marangisto/Resonator/Spice/CodecOutput.asc

C1: cap; 470p
C2: cap; 470p
C3: cap; 1500p
R1: res; 820
R2: res; 10k
R3: res; 820
R4: res; 10k
R5: res; 15k
R6: res; 33k
R7: res; 33k
R28: res; 1k
R29: res; 15k
U1: opamp2; TL071
U4: opamp2; TL071
V1: voltage; 12
V2: voltage; SINE(0 5 1k); AC 1
V3: voltage; -12
V4: voltage; 2.5
V5: voltage; 5
Vcv: voltage; PWL(0 2.5 1m 2.5 2m 4.5 4m 0.5 5m 2.5)
Named nets: 0, VCC, VSS, Vin2, Vin, Output, VOut+, VCom, V5V, VOut-
.include TL071.mod
.tran 0 6mm 0 500n
