marangisto/Resonator/Spice/CodecInput.asc

C1: cap; 10µ
C2: cap; 120p
D1: schottky; 1N5819
D2: schottky; 1N5819
R3: res; 100k
R28: res; 1k
R29: res; 30k
U4: opamp2; TL071
V1: voltage; 12
V2: voltage; SINE(0 5 1k); AC 1
V3: voltage; -12
V4: voltage; 2.5
V5: voltage; 5
Vcv: voltage; PWL(0 0 1m 0 2m -5 3m 5 4m 0 5m 0 6m -12 8m 12 9m 0 10m 0)
Named nets: 0, VCC, VSS, Vin2, Vin, Out, VCom, V5V
.include TL071.mod
.tran 0 10mm 0 500n
