marangisto/Resonator/Resonator.kicad_pcb

## KiCad design Resonator.kicad_pcb (2022-01-10)

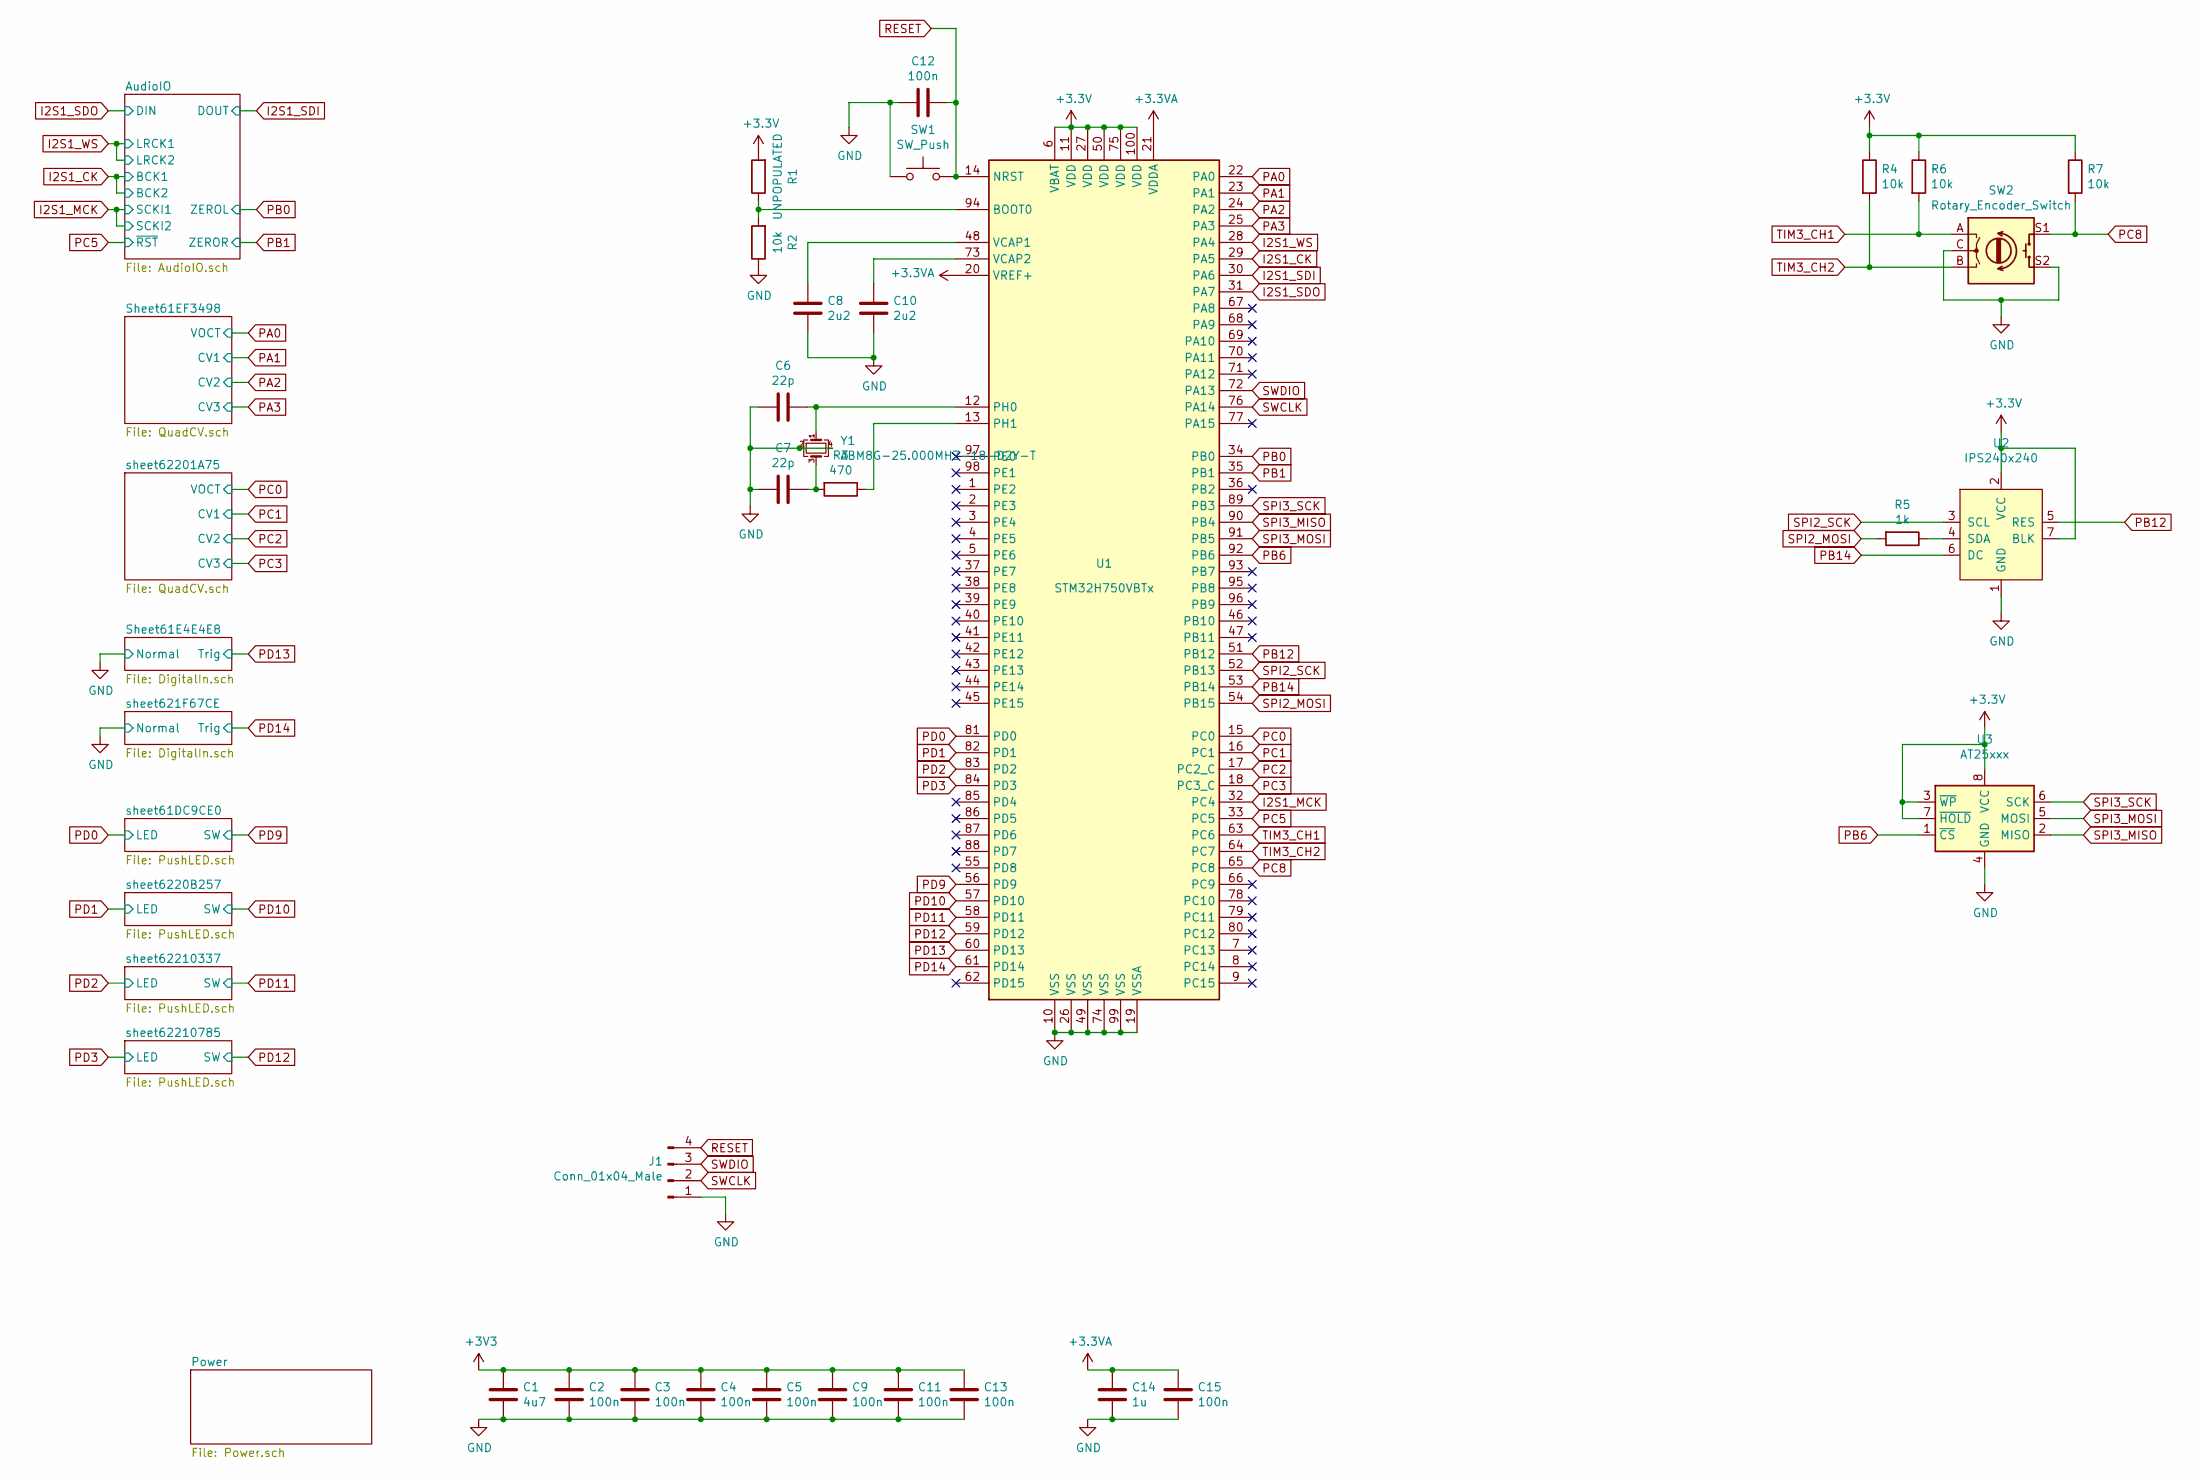
[picture p1: schematic Resonator.sch]

Parts:
C1: 4u7; C_0805_2012Metric
C2, C3, C4, C5, C9, C11, C12, C13, C15: 100n; C_0402_1005Metric
C6, C7: 22p; C_0402_1005Metric
C8, C10: 2u2; C_0805_2012Metric
C14: 1u; C_0805_2012Metric
J1: Conn_01x04_Male; PinHeader_1x04_P2.54mm_Vertical
R1: UNPOPULATED; R_0603_1608Metric
R2, R4, R6, R7: 10k; R_0603_1608Metric
R3: 470; R_0603_1608Metric
R5: 1k; R_0603_1608Metric
SW1: SW_Push; SW_PUSH_6mm
SW2: Rotary_Encoder_Switch; RotaryEncoder_Alps_EC11E-Switch_Vertical_H20mm
U1: STM32H750VBTx; LQFP-100_14x14mm_P0.5mm
U2: IPS240x240
U3: AT25xxx; TSSOP-8_4.4x3mm_P0.65mm
Y1: ABM8G-25.000MHZ-18-D2Y-T; Crystal_SMD_Abracon_ABM8G-4Pin_3.2x2.5mm

Connections:
+3.3VA: C14.1, C15.1, U1.20 (VREF+), U1.21 (VDDA); also elsewhere on the board
GND: C1.2, C2.2, C3.2, C4.2, C5.2, C6.2, C7.2, C8.2, C9.2, C10.2, C11.2, C12.2, C13.2, C14.2, C15.2, J1.1, R2.1, SW1.1, SW2.C, SW2.S2, U1.10 (VSS), U1.19 (VSSA), U1.26 (VSS), U1.49 (VSS), U1.74 (VSS), U1.99 (VSS), U2.1 (GND), U3.4 (GND), Y1.2, Y1.4; also elsewhere on the board
I2S1_CK: U1.29 (PA5); also elsewhere on the board
I2S1_MCK: U1.32 (PC4); also elsewhere on the board
I2S1_SDI: U1.30 (PA6); also elsewhere on the board
I2S1_SDO: U1.31 (PA7); also elsewhere on the board
I2S1_WS: U1.28 (PA4); also elsewhere on the board
unnamed: C6.1, U1.12 (PH0), Y1.1
unnamed: C7.1, R3.2, Y1.3
unnamed: C8.1, U1.48 (VCAP1)
unnamed: C10.1, U1.73 (VCAP2)
unnamed: R1.1, R2.2, U1.94 (BOOT0)
unnamed: R3.1, U1.13 (PH1)
unnamed: R5.1, U2.4 (SDA)
PA0: U1.22 (PA0); also elsewhere on the board
PA1: U1.23 (PA1); also elsewhere on the board
PA2: U1.24 (PA2); also elsewhere on the board
PA3: U1.25 (PA3); also elsewhere on the board
PB0: U1.34 (PB0); also elsewhere on the board
PB1: U1.35 (PB1); also elsewhere on the board
PB6: U1.92 (PB6), U3.1 (~CS)
PB12: U1.51 (PB12), U2.5 (RES)
PB14: U1.53 (PB14), U2.6 (DC)
PC0: U1.15 (PC0); also elsewhere on the board
PC1: U1.16 (PC1); also elsewhere on the board
PC2: U1.17 (PC2_C); also elsewhere on the board
PC3: U1.18 (PC3_C); also elsewhere on the board
PC5: U1.33 (PC5); also elsewhere on the board
PC8: R7.2, SW2.S1, U1.65 (PC8)
PD0: U1.81 (PD0); also elsewhere on the board
PD1: U1.82 (PD1); also elsewhere on the board
PD2: U1.83 (PD2); also elsewhere on the board
PD3: U1.84 (PD3); also elsewhere on the board
PD9: U1.56 (PD9); also elsewhere on the board
PD10: U1.57 (PD10); also elsewhere on the board
PD11: U1.58 (PD11); also elsewhere on the board
PD12: U1.59 (PD12); also elsewhere on the board
PD13: U1.60 (PD13); also elsewhere on the board
PD14: U1.61 (PD14); also elsewhere on the board
RESET: C12.1, J1.4, SW1.2, U1.14 (NRST)
SPI2_MOSI: R5.2, U1.54 (PB15)
SPI2_SCK: U1.52 (PB13), U2.3 (SCL)
SPI3_MISO: U1.90 (PB4), U3.2 (MISO)
SPI3_MOSI: U1.91 (PB5), U3.5 (MOSI)
SPI3_SCK: U1.89 (PB3), U3.6 (SCK)
SWCLK: J1.2, U1.76 (PA14)
SWDIO: J1.3, U1.72 (PA13)
TIM3_CH1: R6.2, SW2.A, U1.63 (PC6)
TIM3_CH2: R4.2, SW2.B, U1.64 (PC7)

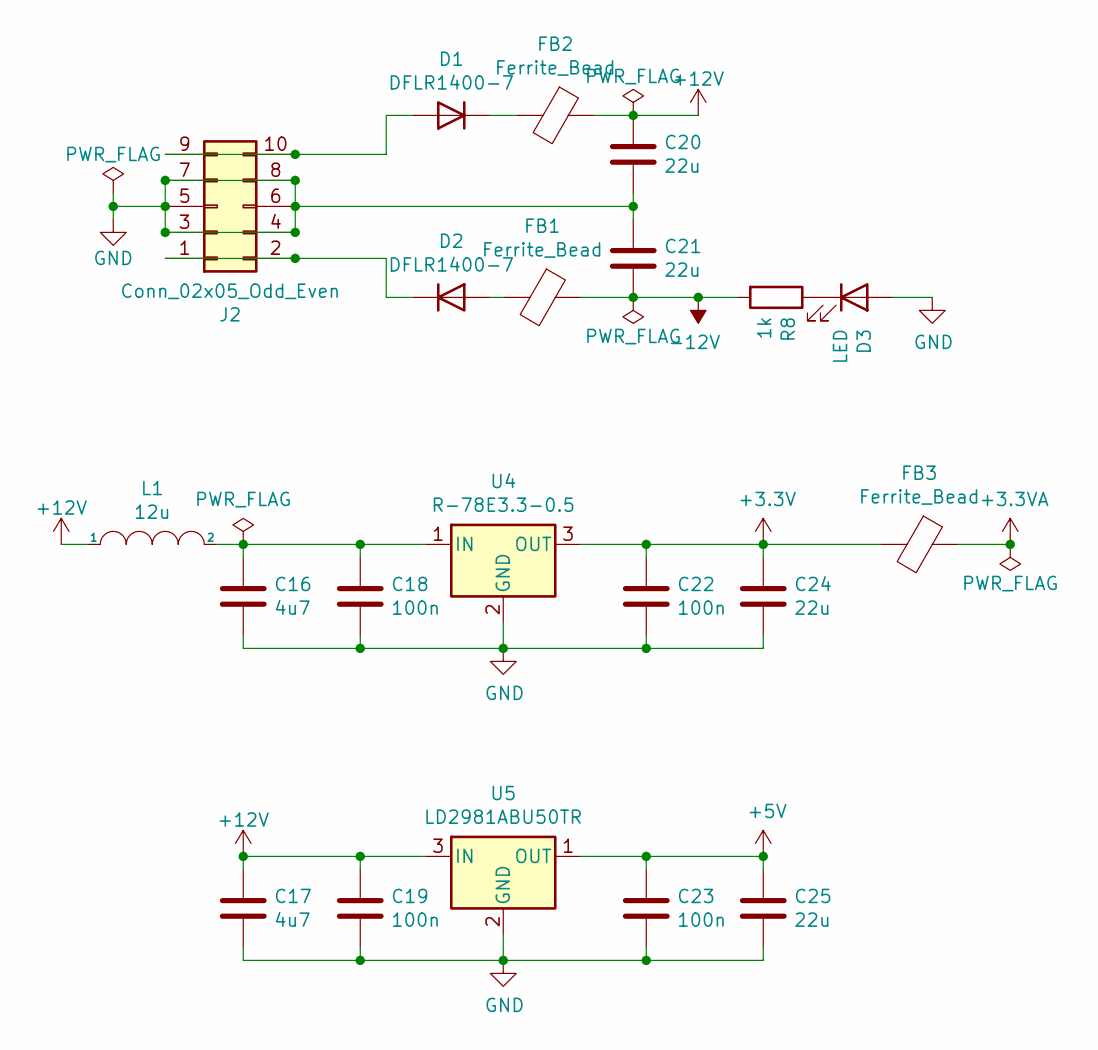
[picture p2: schematic Power.sch]

Parts:
C16, C17: 4u7; C_0805_2012Metric
C18, C19, C22, C23: 100n; C_0402_1005Metric
C20, C21, C24, C25: 22u; C_1206_3216Metric
D1, D2: DFLR1400-7; D_PowerDI-123
D3: LED; LED_0603_1608Metric_Castellated
FB1, FB2, FB3: Ferrite_Bead; L_0603_1608Metric
J2: Conn_02x05_Odd_Even; PinHeader_2x05_P2.54mm_Vertical
L1: 12u; L_Coilcraft_LPS3010
R8: 1k; R_0603_1608Metric
U4: R-78E3.3-0.5; Converter_DCDC_RECOM_R-78E-0.5_THT
U5: LD2981ABU50TR; SOT-89-3

Connections:
+3.3VA: FB3.1; also elsewhere on the board
+5V: C23.1, C25.1, U5.1 (OUT); also elsewhere on the board
+12V: C17.1, C19.1, C20.1, FB2.1, L1.1, U5.3 (IN); also elsewhere on the board
-12V: C21.2, FB1.1, R8.2; also elsewhere on the board
GND: C16.2, C17.2, C18.2, C19.2, C20.2, C21.1, C22.2, C23.2, C24.2, C25.2, D3.2 (A), J2.3, J2.4, J2.5, J2.6, J2.7, J2.8, U4.2 (GND), U5.2 (GND); also elsewhere on the board
unnamed: C16.1, C18.1, L1.2, U4.1 (IN)
unnamed: D1.1 (K), FB2.2
unnamed: D1.2 (A), J2.9, J2.10
unnamed: D2.1 (K), J2.1, J2.2
unnamed: D2.2 (A), FB1.2
unnamed: D3.1 (K), R8.1

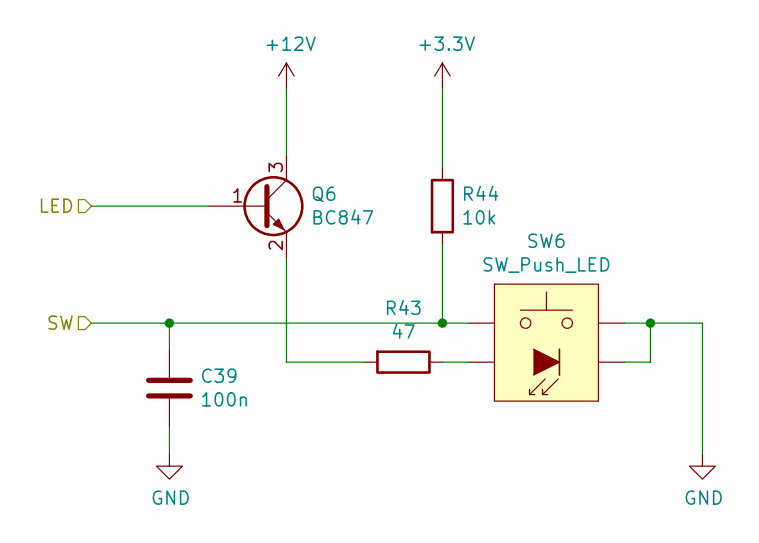
[picture p3: schematic PushLED.sch]

Parts:
C26: 100n; C_0402_1005Metric
Q1: BC847; SOT-23
R9: 47; R_0603_1608Metric
R10: 10k; R_0603_1608Metric
SW3: SW_Push_LED; SW_PUSH_LED_6mm

Connections:
+12V: Q1.3 (C); also elsewhere on the board
GND: C26.2, SW3.2, SW3.4 (K); also elsewhere on the board
unnamed: Q1.2 (E), R9.2
unnamed: R9.1, SW3.3 (A)
PD0: Q1.1 (B); also elsewhere on the board
PD9: C26.1, R10.2, SW3.1; also elsewhere on the board

Parts of its further copies:
C37, C38, C39: 100n; C_0402_1005Metric
Q4, Q5, Q6: BC847; SOT-23
R39, R41, R43: 47; R_0603_1608Metric
R40, R42, R44: 10k; R_0603_1608Metric
SW4, SW5, SW6: SW_Push_LED; SW_PUSH_LED_6mm

Connections of its further copies:
+12V: Q4.3 (C), Q5.3 (C), Q6.3 (C); also elsewhere on the board
GND: C37.2, C38.2, C39.2, SW4.2, SW4.4 (K), SW5.2, SW5.4 (K), SW6.2, SW6.4 (K); also elsewhere on the board
unnamed: Q4.2 (E), R39.2
unnamed: Q5.2 (E), R41.2
unnamed: Q6.2 (E), R43.2
unnamed: R39.1, SW4.3 (A)
unnamed: R41.1, SW5.3 (A)
unnamed: R43.1, SW6.3 (A)
PD1: Q4.1 (B); also elsewhere on the board
PD2: Q5.1 (B); also elsewhere on the board
PD3: Q6.1 (B); also elsewhere on the board
PD10: C37.1, R40.2, SW4.1; also elsewhere on the board
PD11: C38.1, R42.2, SW5.1; also elsewhere on the board
PD12: C39.1, R44.2, SW6.1; also elsewhere on the board

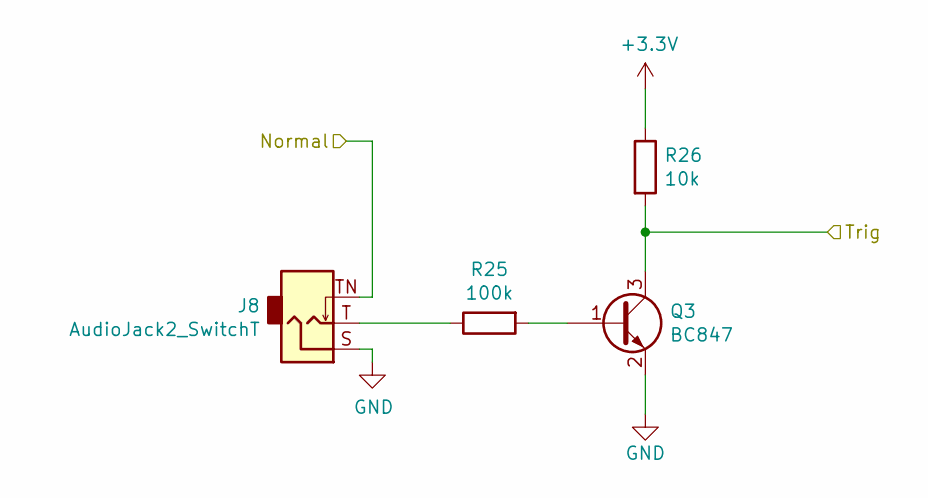
[picture p4: schematic DigitalIn.sch]

Parts:
J3: AudioJack2_SwitchT; PJ398SM
Q2: BC847; SOT-23
R11: 100k; R_0603_1608Metric
R12: 10k; R_0603_1608Metric

Connections:
GND: J3.S, J3.TN, Q2.2 (E); also elsewhere on the board
unnamed: J3.T, R11.1
unnamed: Q2.1 (B), R11.2
PD13: Q2.3 (C), R12.2; also elsewhere on the board

Parts of its further copies:
J8: AudioJack2_SwitchT; PJ398SM
Q3: BC847; SOT-23
R25: 100k; R_0603_1608Metric
R26: 10k; R_0603_1608Metric

Connections of its further copies:
GND: J8.S, J8.TN, Q3.2 (E); also elsewhere on the board
unnamed: J8.T, R25.1
unnamed: Q3.1 (B), R25.2
PD14: Q3.3 (C), R26.2; also elsewhere on the board

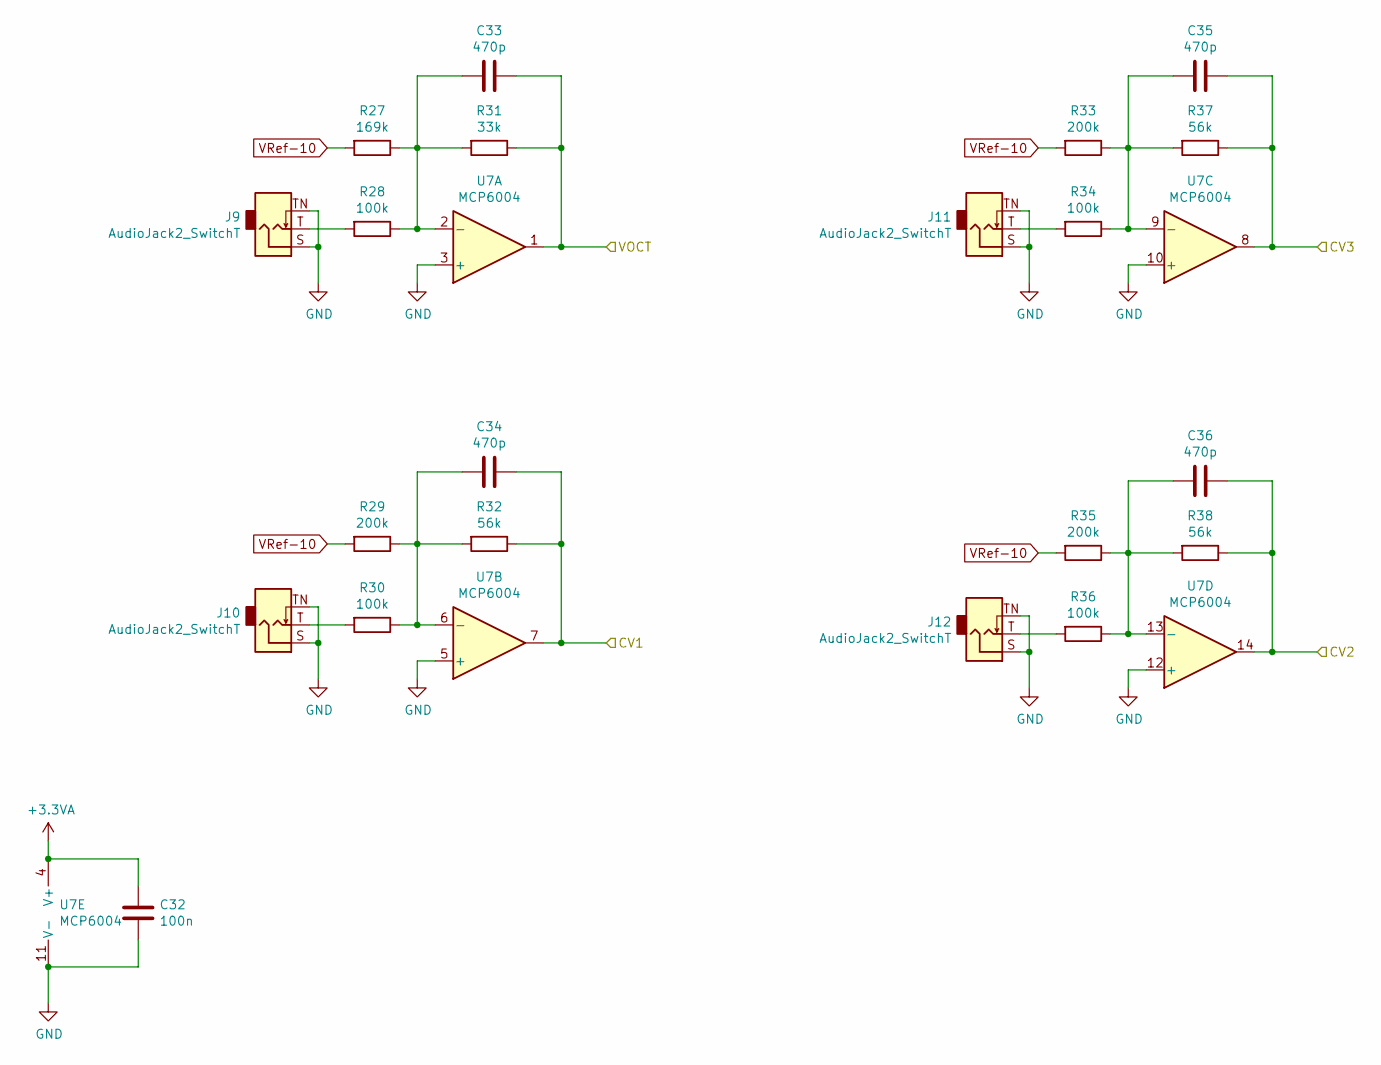
[picture p5: schematic QuadCV.sch]

Parts:
C27: 100n; C_0402_1005Metric
C28, C29, C30, C31: 470p; C_0603_1608Metric
J4, J5, J6, J7: AudioJack2_SwitchT; PJ398SM
R13: 169k; R_0603_1608Metric
R14, R16, R20, R22: 100k; R_0603_1608Metric
R15, R19, R21: 200k; R_0603_1608Metric
R17: 33k; R_0603_1608Metric
R18, R23, R24: 56k; R_0603_1608Metric
U6: MCP6004; TSSOP-14_4.4x5mm_P0.65mm

Connections:
+3.3VA: C27.1, U6.4 (V+); also elsewhere on the board
GND: C27.2, J4.S, J4.TN, J5.S, J5.TN, J6.S, J6.TN, J7.S, J7.TN, U6.3 (+), U6.5 (+), U6.10 (+), U6.11 (V-), U6.12 (+); also elsewhere on the board
unnamed: C28.2, R13.1, R14.1, R17.2, U6.2 (-)
unnamed: C29.2, R15.1, R16.1, R18.2, U6.6 (-)
unnamed: C30.2, R19.1, R20.1, R23.2, U6.9 (-)
unnamed: C31.2, R21.1, R22.1, R24.2, U6.13 (-)
unnamed: J4.T, R14.2
unnamed: J5.T, R16.2
unnamed: J6.T, R20.2
unnamed: J7.T, R22.2
PA0: C28.1, R17.1, U6.1; also elsewhere on the board
PA1: C29.1, R18.1, U6.7; also elsewhere on the board
PA2: C31.1, R24.1, U6.14; also elsewhere on the board
PA3: C30.1, R23.1, U6.8; also elsewhere on the board
VRef-10: R13.2, R15.2, R19.2, R21.2; also elsewhere on the board

Parts of its further copies:
C32: 100n; C_0402_1005Metric
C33, C34, C35, C36: 470p; C_0603_1608Metric
J9, J10, J11, J12: AudioJack2_SwitchT; PJ398SM
R27: 169k; R_0603_1608Metric
R28, R30, R34, R36: 100k; R_0603_1608Metric
R29, R33, R35: 200k; R_0603_1608Metric
R31: 33k; R_0603_1608Metric
R32, R37, R38: 56k; R_0603_1608Metric
U7: MCP6004; TSSOP-14_4.4x5mm_P0.65mm

Connections of its further copies:
+3.3VA: C32.1, U7.4 (V+); also elsewhere on the board
GND: C32.2, J9.S, J9.TN, J10.S, J10.TN, J11.S, J11.TN, J12.S, J12.TN, U7.3 (+), U7.5 (+), U7.10 (+), U7.11 (V-), U7.12 (+); also elsewhere on the board
unnamed: C33.2, R27.1, R28.1, R31.2, U7.2 (-)
unnamed: C34.2, R29.1, R30.1, R32.2, U7.6 (-)
unnamed: C35.2, R33.1, R34.1, R37.2, U7.9 (-)
unnamed: C36.2, R35.1, R36.1, R38.2, U7.13 (-)
unnamed: J9.T, R28.2
unnamed: J10.T, R30.2
unnamed: J11.T, R34.2
unnamed: J12.T, R36.2
PC0: C33.1, R31.1, U7.1; also elsewhere on the board
PC1: C34.1, R32.1, U7.7; also elsewhere on the board
PC2: C36.1, R38.1, U7.14; also elsewhere on the board
PC3: C35.1, R37.1, U7.8; also elsewhere on the board
VRef-10: R27.2, R29.2, R33.2, R35.2; also elsewhere on the board

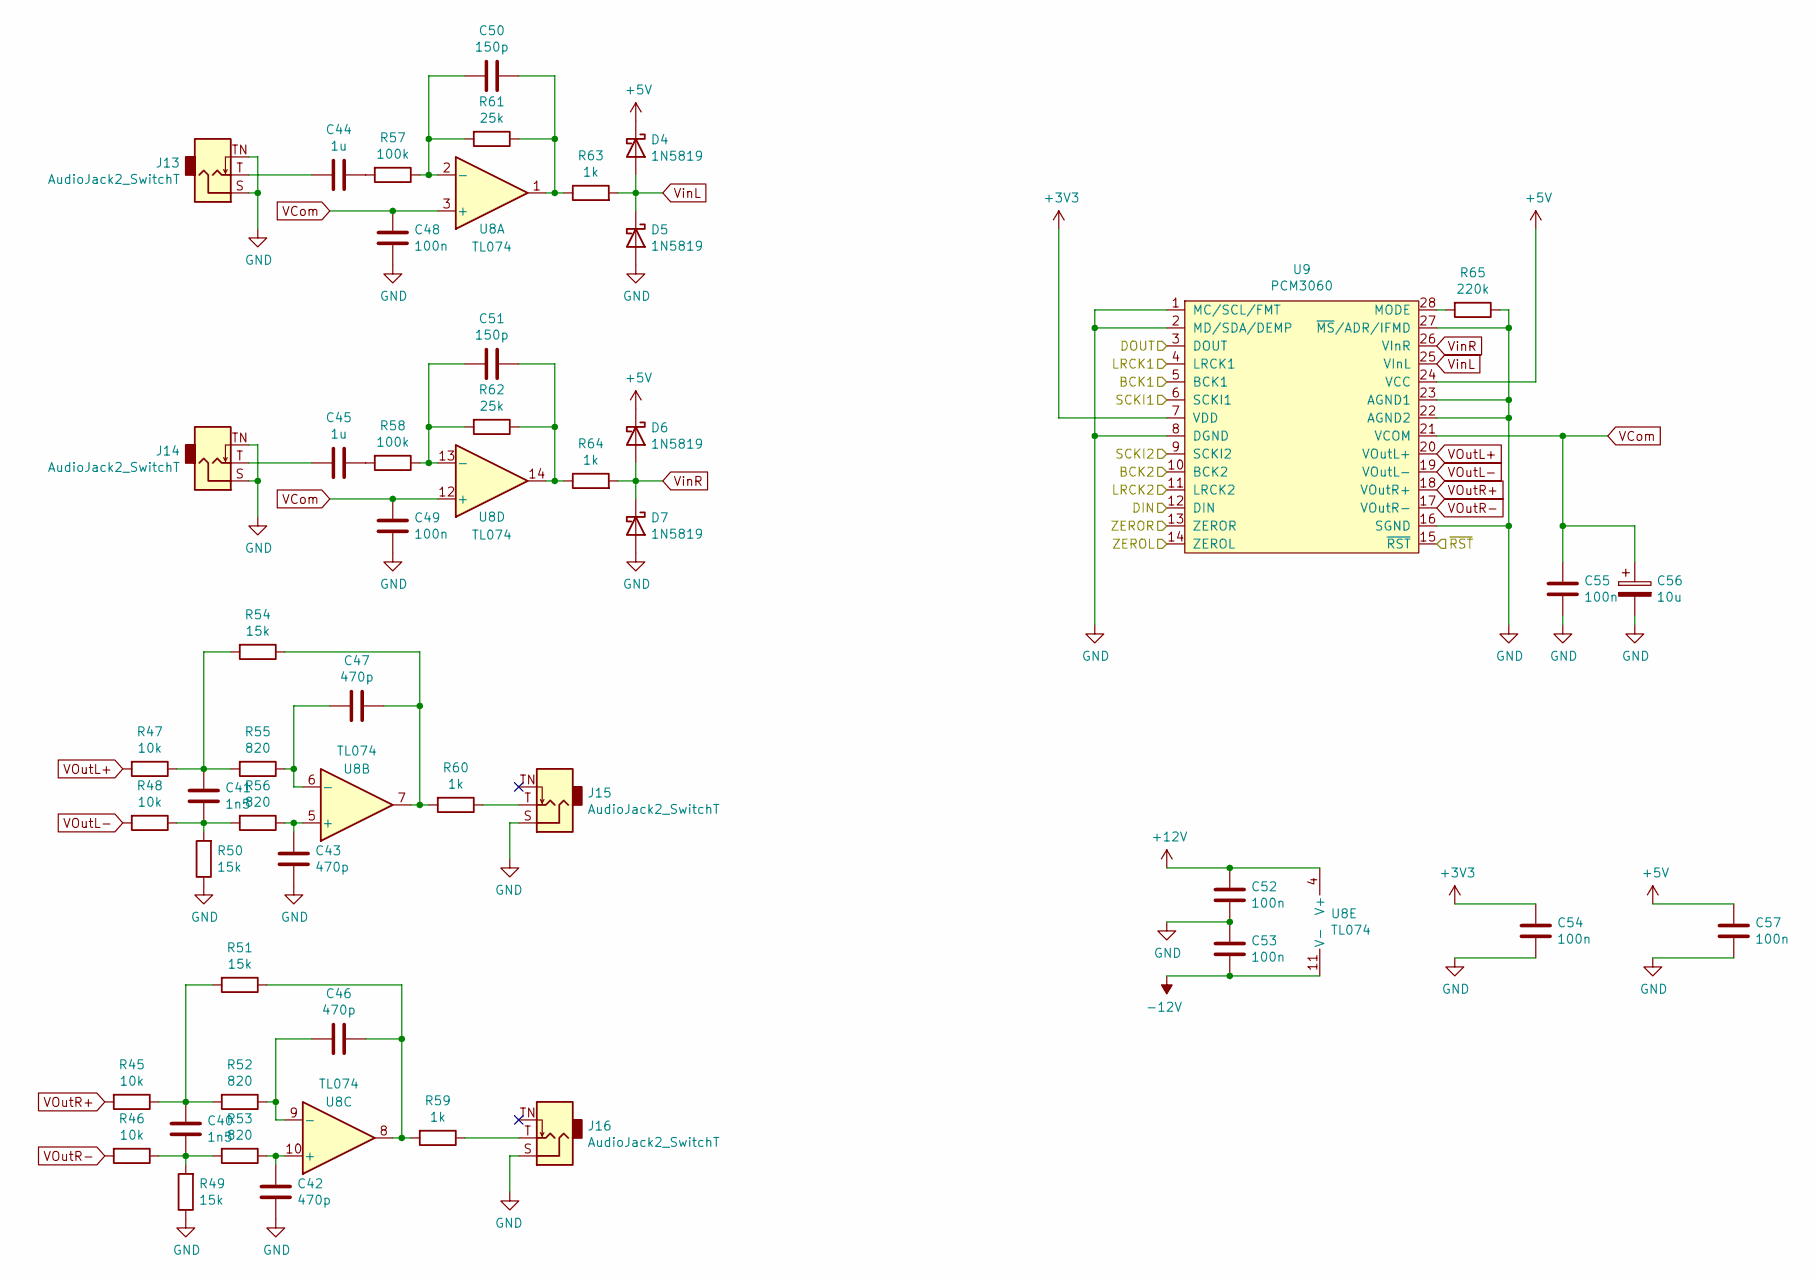
[picture p6: schematic AudioIO.sch]

Parts:
C40, C41: 1n5; C_0603_1608Metric
C42, C43, C46, C47: 470p; C_0603_1608Metric
C44, C45: 1u; C_1210_3225Metric
C48, C49, C52, C53, C54, C55, C57: 100n; C_0402_1005Metric
C50, C51: 150p; C_0603_1608Metric
C56: 10u; C_0603_1608Metric
D4, D5, D6, D7: 1N5819; D_SOD-123
J13, J14, J15, J16: AudioJack2_SwitchT; PJ398SM
R45, R46, R47, R48: 10k; R_0603_1608Metric
R49, R50, R51, R54: 15k; R_0603_1608Metric
R52, R53, R55, R56: 820; R_0603_1608Metric
R57, R58: 100k; R_0603_1608Metric
R59, R60, R63, R64: 1k; R_0603_1608Metric
R61, R62: 25k; R_0603_1608Metric
R65: 220k; R_0603_1608Metric
U8: TL074; TSSOP-14_4.4x5mm_P0.65mm
U9: PCM3060; TSSOP-28_4.4x9.7mm_P0.65mm

Connections:
+5V: C57.1, D4.1 (K), D6.1 (K), U9.24 (VCC); also elsewhere on the board
+12V: C52.1, U8.4 (V+); also elsewhere on the board
-12V: C53.2, U8.11 (V-); also elsewhere on the board
GND: C42.2, C43.2, C48.2, C49.2, C52.2, C53.1, C54.2, C55.2, C56.2, C57.2, D5.2 (A), D7.2 (A), J13.S, J13.TN, J14.S, J14.TN, J15.S, J16.S, R49.1, R50.1, R65.1, U9.1 (MC/SCL/FMT), U9.2 (MD/SDA/DEMP), U9.8 (DGND), U9.16 (SGND), U9.22 (AGND2), U9.23 (AGND1), U9.27 (~MS~/ADR/IFMD); also elsewhere on the board
I2S1_CK: U9.5 (BCK1), U9.10 (BCK2); also elsewhere on the board
I2S1_MCK: U9.6 (SCKI1), U9.9 (SCKI2); also elsewhere on the board
I2S1_SDI: U9.3 (DOUT); also elsewhere on the board
I2S1_SDO: U9.12 (DIN); also elsewhere on the board
I2S1_WS: U9.4 (LRCK1), U9.11 (LRCK2); also elsewhere on the board
unnamed: C40.1, R45.1, R51.2, R52.2
unnamed: C40.2, R46.1, R49.2, R53.2
unnamed: C41.1, R47.1, R54.2, R55.2
unnamed: C41.2, R48.1, R50.2, R56.2
unnamed: C42.1, R53.1, U8.10 (+)
unnamed: C43.1, R56.1, U8.5 (+)
unnamed: C44.1, R57.2
unnamed: C44.2, J13.T
unnamed: C45.1, R58.2
unnamed: C45.2, J14.T
unnamed: C46.1, R51.1, R59.2, U8.8
unnamed: C46.2, R52.1, U8.9 (-)
unnamed: C47.1, R54.1, R60.2, U8.7
unnamed: C47.2, R55.1, U8.6 (-)
unnamed: C50.1, R61.1, R63.1, U8.1
unnamed: C50.2, R57.1, R61.2, U8.2 (-)
unnamed: C51.1, R62.1, R64.1, U8.14
unnamed: C51.2, R58.1, R62.2, U8.13 (-)
unnamed: J15.T, R60.1
unnamed: J16.T, R59.1
unnamed: R65.2, U9.28 (MODE)
PB0: U9.14 (ZEROL); also elsewhere on the board
PB1: U9.13 (ZEROR); also elsewhere on the board
PC5: U9.15 (~RST); also elsewhere on the board
VCom: C48.1, C49.1, C55.1, C56.1, U8.3 (+), U8.12 (+), U9.21 (VCOM)
VOutL+: R47.2, U9.20 (VOutL+)
VOutL-: R48.2, U9.19 (VOutL-)
VOutR+: R45.2, U9.18 (VOutR+)
VOutR-: R46.2, U9.17 (VOutR-)
VinL: D4.2 (A), D5.1 (K), R63.2, U9.25 (VInL)
VinR: D6.2 (A), D7.1 (K), R64.2, U9.26 (VInR)

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
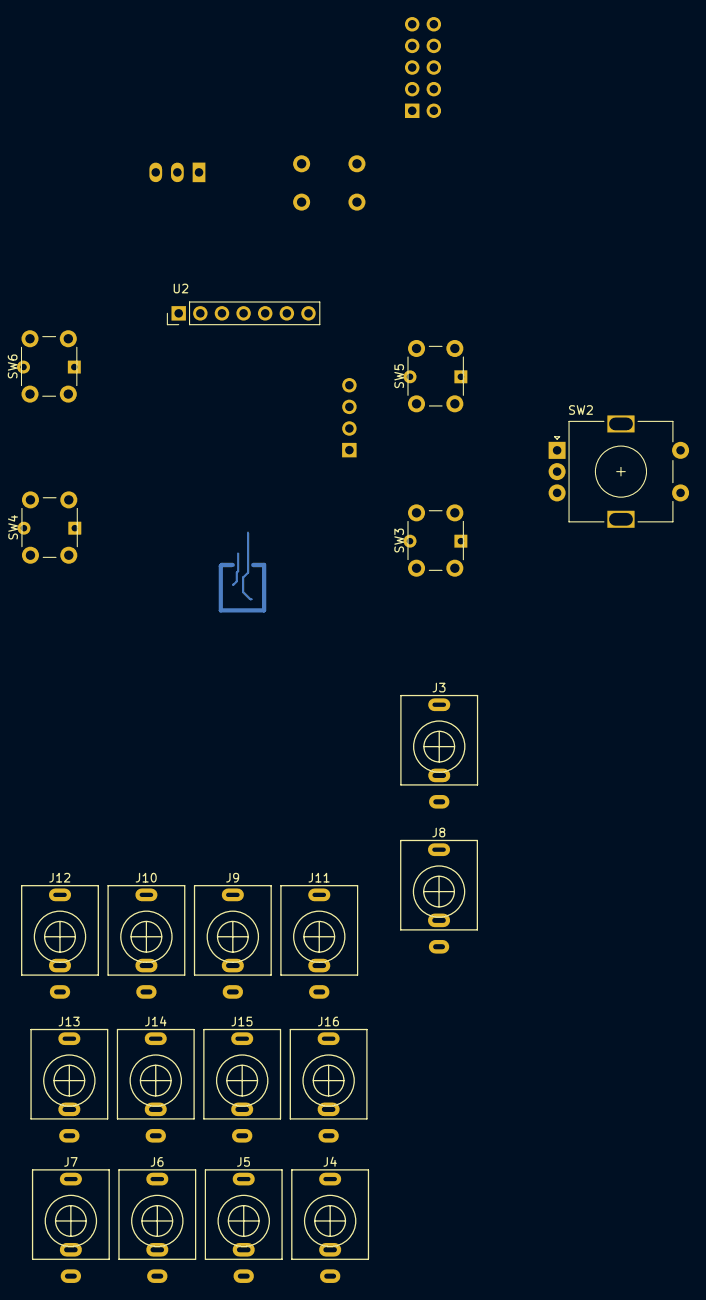
[picture p7: board Resonator.kicad_pcb from above]

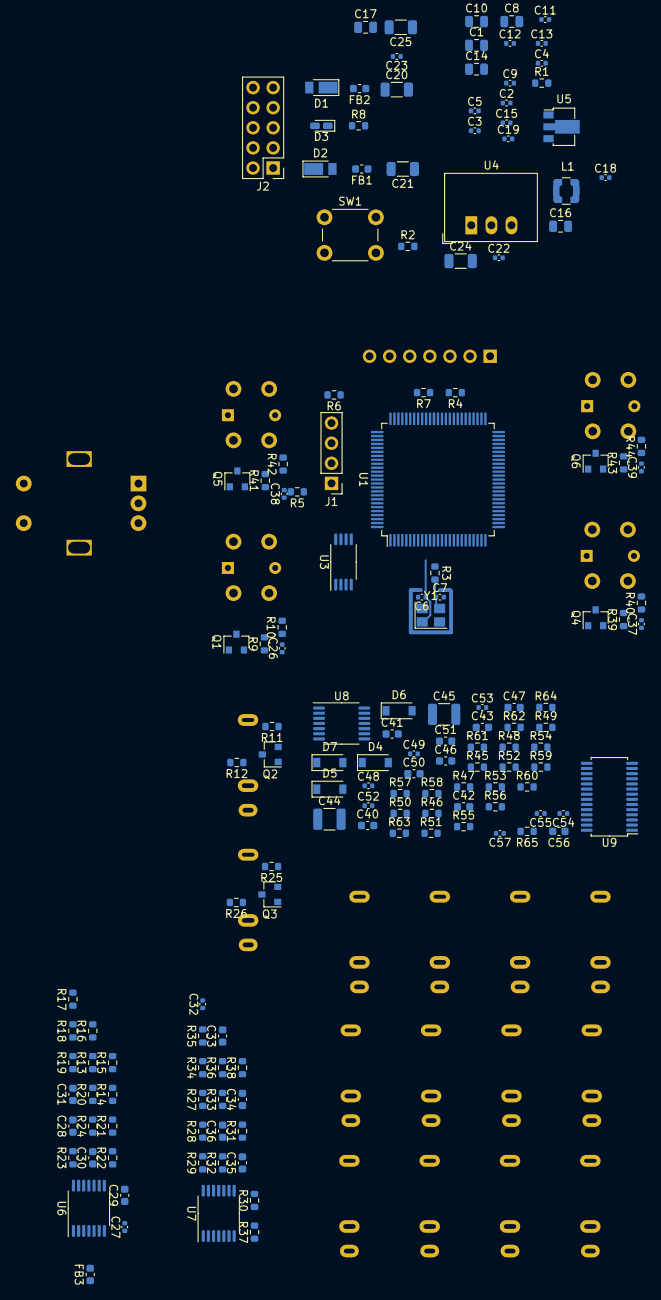
[picture p8: board Resonator.kicad_pcb from below]

Board: 2 copper layers, 171 parts (151 on the bottom side), 116 nets.
