marangisto/Resonator/(commit log)

2021-11-21 Skeleton project.
    [Resonator.kicad_pcb, Resonator.sch]
2021-11-21 Added PCM3060 symbol and initial wiring.
    [Resonator.sch]
2021-11-22 More work on basic configuraiton of CODEC.
    [Resonator.sch]
2021-11-23 Corrected reset pin assignment.
    [Resonator.sch]
2021-11-27 Added input stage spice simulation.
2021-11-27 Added input stages to schema.
    [Resonator.sch]
2021-11-28 Added output stage spice simulation.
2021-11-28 Output stage schematic.
    [Resonator.sch]
2021-11-28 Some early placement.
    [Resonator.kicad_pcb, Resonator.sch]
2021-11-28 Added power supply and adjusted gains for 12Vpp I/O.
    [Power.sch, Resonator.kicad_pcb, Resonator.sch]
2021-11-29 Moved audio-io to separate sheet.
    [AudioIO.sch, Power.sch, Resonator.kicad_pcb, Resonator.sch]
2021-11-29 Added STM32750 mcu.
    [Power.sch, Resonator.kicad_pcb, Resonator.sch]
2021-12-04 Chanced regulators and oscillator work.
    [AudioIO.sch, Crystal.xlsx, Power.sch, Resonator.kicad_pcb, Resonator.sch]
2022-01-09 Reusable digital input.
    [DigitalIn.sch]
2022-01-09 Reusable Quad CV input module.
    [QuadCV.sch]
2022-01-09 Added UI components.
    [AudioIO.sch, DAC.sch, DigitalIn.sch, Power.sch, PushLED.sch, QuadCV.sch, Resonator.sch, Waves.sch]
2022-01-09 Moved codec to audio module.
    [AudioIO.sch, DigitalIn.sch, PushLED.sch, QuadCV.sch, Resonator.sch]
2022-01-10 Assigned pins and cleared schema rules.
    [AudioIO.sch, DigitalIn.sch, Power.sch, PushLED.sch, QuadCV.sch, Resonator.kicad_pcb, Resonator.sch]
